topnotchdsp/core-symlib/(commit log)

2022-05-09 Add 0804 footprint for quad 0-ohm resistor
2022-05-09 Add quad 1kOhm resistor
2022-05-09 Add Molex Push-Push Micro SD connector (8+1 pos)
2022-05-09 Add 3mm LED 4x
2022-05-09 Add MMPQ2222A quad NPN transistor array 40V 0.5A
2022-08-06 Add R Pi Pico symbol
2022-12-09 Add SX176IMLTRT symbol & footprint
2022-12-09 Shuffle for KiCad on Linux
2022-12-09 Add SX176IMLTRT footprint, actually
2022-12-17 Add EC template
    [Kris_Expansion_Card.kicad_pcb, Kris_Expansion_Card.kicad_sch]
2025-01-27 Add ESP32-C6-DevKitM-1
2025-02-03 Rename local files to 000-core-symlib, remove Frame.work expansion card project
    [Kris_Expansion_Card.kicad_pcb, Kris_Expansion_Card.kicad_sch]
2025-02-03 Update MiniIO symbol with 1J/2J pin numbers
